Loredati-svg/TPA3116D2-Class-D-Amplifier/KiCad_Project/Audio_Amp_v1/Audio_Amp_v1.kicad_pcb

## KiCad design KiCad_Project/Audio_Amp_v1/Audio_Amp_v1.kicad_pcb (2026-10-24)

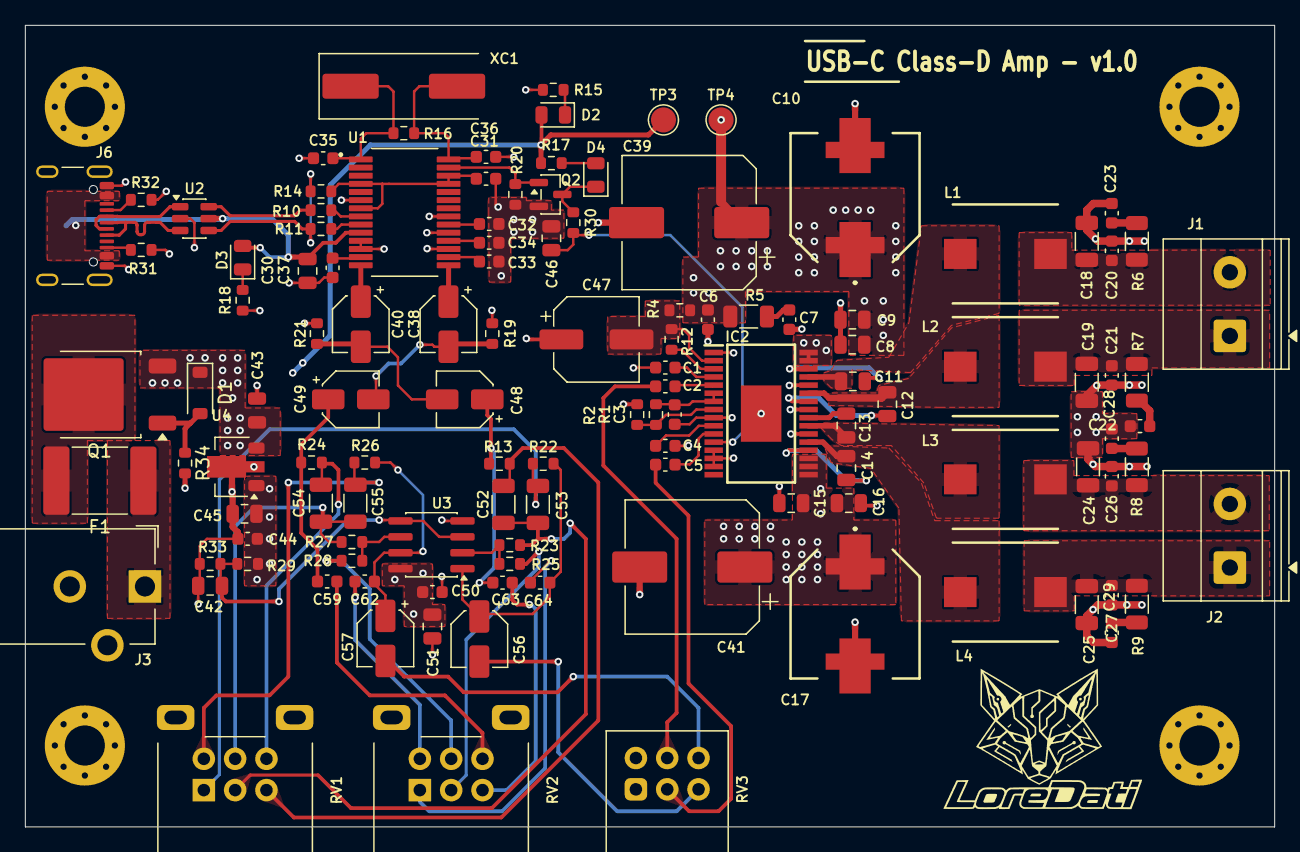
[picture p3: board Audio_Amp_v1.kicad_pcb from above]

Board: 4 copper layers, 99.8 x 64.0 mm, 124 parts (0 on the bottom side), 80 nets.

Parts:
C1, C2, C4, C5: 3u3; C_0603_1608Metric
C3, C31, C32, C33, C37: 1u; C_0603_1608Metric
C6, C22, C23, C28, C29: 10n; C_0603_1608Metric
C7, C50: 100n; C_0603_1608Metric
C8, C15: 1n; C_0805_2012Metric
C9, C16: 100n; C_0805_2012Metric
C10, C17: 220u; EEHZT1E561UV
C11, C12, C13, C14: 220n; C_0805_2012Metric
C18, C19, C24, C25: 680n; C_1206_3216Metric
C20, C21, C26, C27: 1n; C_0603_1608Metric
C30, C42, C45, C51: 10u; C_0805_2012Metric
C34: 10u; C_0603_1608Metric
C35, C36: 33p; C_0603_1608Metric
C38, C40, C48, C49, C56, C57: 10u; CP_Elec_4x5.8
C39, C41: 470u; CP_Elec_10x10.5
C43: 0.33u; C_0805
C44: 0.1u; C_0603_1608Metric
C46: 4u7; C_0805_2012Metric
C47: 47u; CP_Elec_6.3x5.9
C52, C53, C54, C55: 100n; C_1206_3216Metric
C59, C62, C63, C64: 2n2; C_0603_1608Metric
D1: D_Zener; D_SOD-123
D2, D3, D4: LED; LED_0805_2012Metric
F1: Fuse; Fuse_2920_7451Metric_Pad2.10x5.45mm_HandSolder
H1, H2, H3, H4: MountingHole_Pad; MountingHole_3.2mm_M3_Pad_Via
IC2: TPA3116D2DAD; SOP65P810X120-32N
J1, J2: Screw_Terminal_01x02; TerminalBlock_Phoenix_MKDS-1,5-2-5.08_1x02_P5.08mm_Horizont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
J3: Barrel_Jack_Switch; BarrelJack_CUI_PJ-102AH_Horizontal
J6: USB_C_Receptacle_USB2.0_16P; USB_C_Receptacle_GCT_USB4105-xx-A_16P_TopMnt_Horizontal
L1, L2, L3, L4: 10u; INDPM8479X720N
Q1: Q_PMOS_GDS; TO-252-2
Q2: BSS138; SOT-23
R1, R4, R29, R30, R33: 100k; R_0603_1608Metric
R2: 20k; R_0603_1608Metric
R5, R6, R7, R8, R9: 3.3R; R_1206_3216Metric
R10, R11: 22; R_0603_1608Metric
R12, R18: 1k; R_0603_1608Metric
R13, R20, R22, R23, R24, R26, R27: 10k; R_0603_1608Metric
R14: 1.5k; R_0603_1608Metric
R15, R25, R28: 3k3; R_0603_1608Metric
R16: 1M; R_0603_1608Metric
R17, R19, R21, R34: 47k; R_0603_1608Metric
R31, R32: 5k1; R_0603_1608Metric
RV1, RV2: 100k; Potentiometer_Alps_RK09L_Double_Horizontal
RV3: 10k; Potentiometer_Alps_RK097_Dual_Horizontal
TP3, TP4: TestPoint; TestPoint_Pad_D2.0mm
U1: PCM2704CDB; SOP65P780X200-28N
U2: USBLC6-2SC6; SOT-23-6
U3: OPA1678IDR; SOIC-8_3.9x4.9mm_P1.27mm
U4: L78L12_SOT89; SOT-89-3
XC1: 12Mhz; Crystal_SMD_HC49-SD

Connections:
+12V: C44.1, C45.1, C50.1, C51.1, D2.2 (A), R17.2, R29.2, TP3.1 (1_1), U3.8 (V+), U4.1 (OUT)
+24V: C6.2, C8.1, C9.1, C10.1, C15.1, C16.1, C17.1, C39.1, C41.1, C43.1, D1.1 (K), IC2.17 (AVCC), IC2.18 (PVCC_1), IC2.19 (PVCC_2), IC2.31 (PVCC_3), IC2.32 (PVCC_4), Q1.3 (S), R4.1, R5.1, TP4.1 (1_1), U4.3 (IN)
+24VIN: F1.1, J3.1
/Tone-Volume_control/VREF: C42.1, R29.1, R33.2, U3.3 (+), U3.5 (+)
/USB_DAC/DAC_ACTIVE: Q2.1 (G), R20.2, U1.27 (~SSPND)
/USB_DAC/DAC_D+: R11.2, U1.9 (D+)
/USB_DAC/DAC_D-: R10.2, U1.8 (D-)
/USB_DAC/ESD_D+: R11.1, R14.2, U2.4 (I/O2)
/USB_DAC/ESD_D-: R10.1, U2.6 (I/O1)
/USB_DAC/USB_D+: J6.A6 (D+), J6.B6 (D+), U2.3 (I/O2)
/USB_DAC/USB_D-: J6.A7 (D-), J6.B7 (D-), U2.1 (I/O1)
DAC_L: C40.2, C48.2, R21.2
DAC_R: C38.2, C49.2, R19.2
GNDA: C1.1, C3.1, C4.2, C6.1, C7.1, C8.2, C9.2, C10.2, C15.2, C16.2, C17.2, C18.2, C19.1, C20.2, C21.1, C22.1, C23.2, C24.2, C25.1, C26.2, C27.1, C28.2, C29.1, C30.1, C31.2, C32.1, C33.1, C34.1, C35.1, C36.1, C37.2, C39.2, C41.2, C42.2, C43.2, C44.2, C45.2, C46.2, C47.1, C50.2, C51.2, H1.1 (1_1), H2.1 (1_1), H3.1 (1_1), H4.1 (1_1), IC2.1 (MODSEL), IC2.9 (GND_1), IC2.13 (AM2), IC2.14 (AM1), IC2.15 (AM0), IC2.22 (GND_2), IC2.25 (GND_3), IC2.28 (GND_4), IC2.33 (GND), J3.2, J3.3, J6.A1 (GND), J6.A12 (GND), J6.B1 (GND), J6.B12 (GND), J6.SH (SHIELD), Q2.2 (S), R2.2, R15.2, R18.2, R19.1, R20.1, R21.1, R31.2, R32.2, R33.1, R34.2, RV1.MP (GNDA), RV2.MP (GNDA), RV3.1, RV3.4, U1.6 (DGND), U1.11 (ZGND), U1.12 (AGNDL), U1.17 (AGNDR), U1.19 (PGND), U1.21 (HOST), U2.2 (GND), U3.4 (V-), U4.2 (GND)
IN_P_LEFT: C5.2, RV3.2
IN_P_RIGHT: C2.1, RV3.5
MUTE: C46.1, IC2.12 (MUTE), R30.1
unnamed: C7.2, R5.2
unnamed: C22.2, R7.1
unnamed: C23.1, R6.2
unnamed: C28.1, R8.2
unnamed: C29.2, R9.1
unnamed: C48.1, C63.2, R13.1
unnamed: C49.1, C59.2, R24.1
unnamed: C52.1, C53.1, R23.2, RV1.2
unnamed: C52.2, R13.2, RV1.3
unnamed: C53.2, R22.1, RV1.1
unnamed: C54.1, C55.1, R27.2, RV1.5
unnamed: C54.2, R24.2, RV1.6
unnamed: C55.2, R26.1, RV1.4
unnamed: C56.1, C64.1, R22.2, U3.1
unnamed: C56.2, RV3.3
unnamed: C57.1, C62.1, R26.2, U3.7
unnamed: C57.2, RV3.6
unnamed: C59.1, RV2.6
unnamed: C62.2, RV2.4
unnamed: C63.1, RV2.3
unnamed: C64.2, RV2.1
unnamed: D1.2 (A), Q1.1 (G), R34.1
unnamed: D2.1 (K), R15.1
unnamed: D3.1 (K), R18.1
unnamed: D4.2 (A), R17.1
unnamed: D4.1 (K), Q2.3 (D), R30.2
unnamed: C14.1, IC2.20 (BSNL)
unnamed: C12.1, IC2.26 (BSNR)
unnamed: C13.1, IC2.24 (BSPL)
unnamed: C11.1, IC2.30 (BSPR)
unnamed: IC2.3 (FAULTZ), R12.2
unnamed: IC2.8 (GAIN/SLV), R1.2, R2.1
unnamed: C3.2, IC2.6 (PLIMIT), IC2.7 (GVDD), R1.1
unnamed: C5.1, IC2.11 (LINN)
unnamed: C4.1, IC2.10 (LINP)
unnamed: C14.2, IC2.21 (OUTNL), L4.1
unnamed: C12.2, IC2.27 (OUTNR), L2.2
unnamed: C13.2, IC2.23 (OUTPL), L3.1
unnamed: C11.2, IC2.29 (OUTPR), L1.1
unnamed: C2.2, IC2.5 (RINN)
unnamed: C1.2, IC2.4 (RINP)
unnamed: C47.2, IC2.2 (SDZ), R4.2, R12.1
unnamed: J6.A5 (CC1), R32.1
unnamed: J6.B5 (CC2), R31.1
unnamed: F1.2, Q1.2 (D)
unnamed: R25.1, RV2.2
unnamed: R28.1, RV2.5
unnamed: C31.1, R14.1, U1.4 (PSEL), U1.7 (VDD), U1.25 (TEST1), U1.26 (TEST0)
unnamed: C37.1, U1.13 (VCCL)
unnamed: C32.2, U1.20 (VCCP)
unnamed: C33.2, U1.16 (VCCR)
unnamed: C34.2, U1.18 (VCOM)
unnamed: C40.1, U1.14 (VOUTL)
unnamed: C38.1, U1.15 (VOUTR)
unnamed: C36.2, R16.2, U1.28 (XTI), XC1.2
unnamed: C35.2, R16.1, U1.1 (XTO), XC1.1
unnamed: R23.1, R25.2, U3.2 (-)
unnamed: R27.1, R28.2, U3.6 (-)
OUT_N_LEFT: C25.2, C27.2, J2.1, L4.2, R9.2
OUT_N_RIGHT: C19.2, C21.2, J1.1, L2.1, R7.2
OUT_P_LEFT: C24.1, C26.1, J2.2, L3.2, R8.1
OUT_P_RIGHT: C18.1, C20.1, J1.2, L1.2, R6.1
VBUS: C30.2, D3.2 (A), J6.A4 (VBUS), J6.A9 (VBUS), J6.B4 (VBUS), J6.B9 (VBUS), U1.10 (VBUS), U2.5 (VBUS)
