Loredati-svg/TPA3116D2-Class-D-Amplifier/(notices)

Notices in the files:
README.md:
License: CERN-OHL-P
